zyxtai/subway-led-matrix/cadfiles/LEDmount1.stl

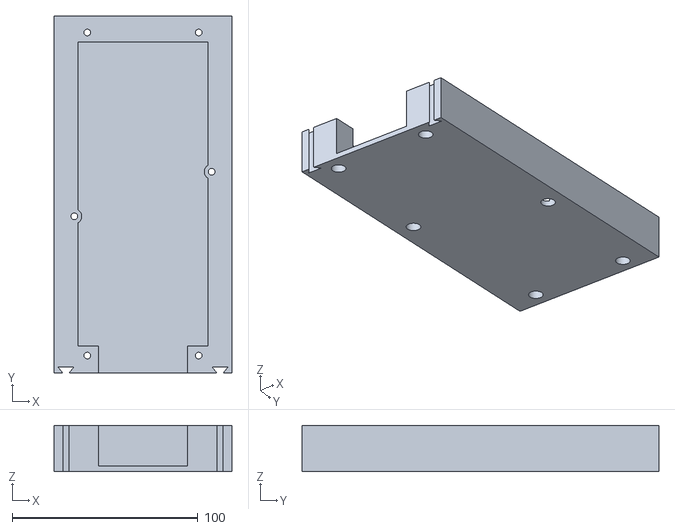
[picture p1: CAD file, 2026-10-25]
cadfiles/LEDmount1.stl
95.8 x 192.3 x 25.0
