zyxtai/subway-led-matrix/cadfiles/LEDmount2.stl

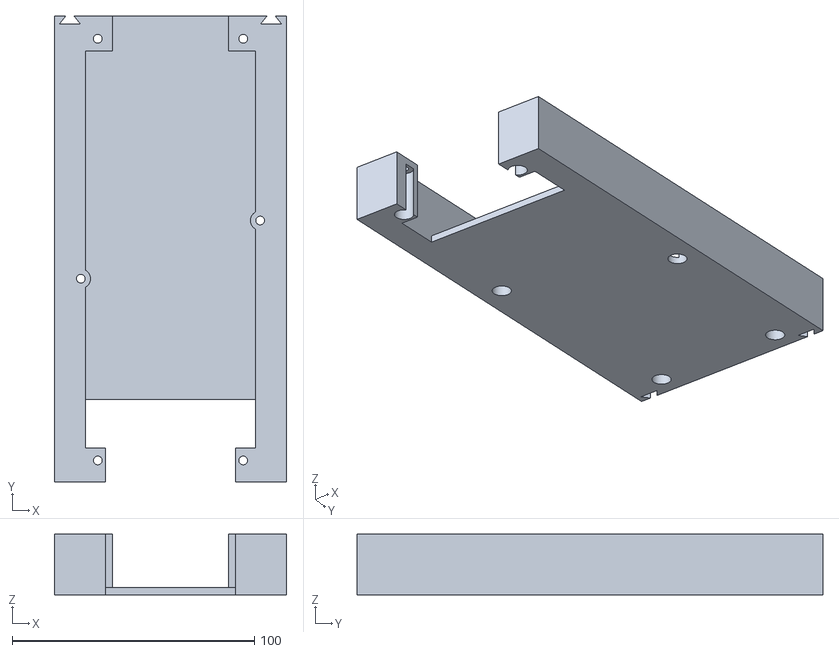
[picture p2: CAD file, 2026-10-25]
cadfiles/LEDmount2.stl
95.8 x 192.3 x 25.0
