zyxtai/subway-led-matrix/cadfiles/connectingpin1.stl

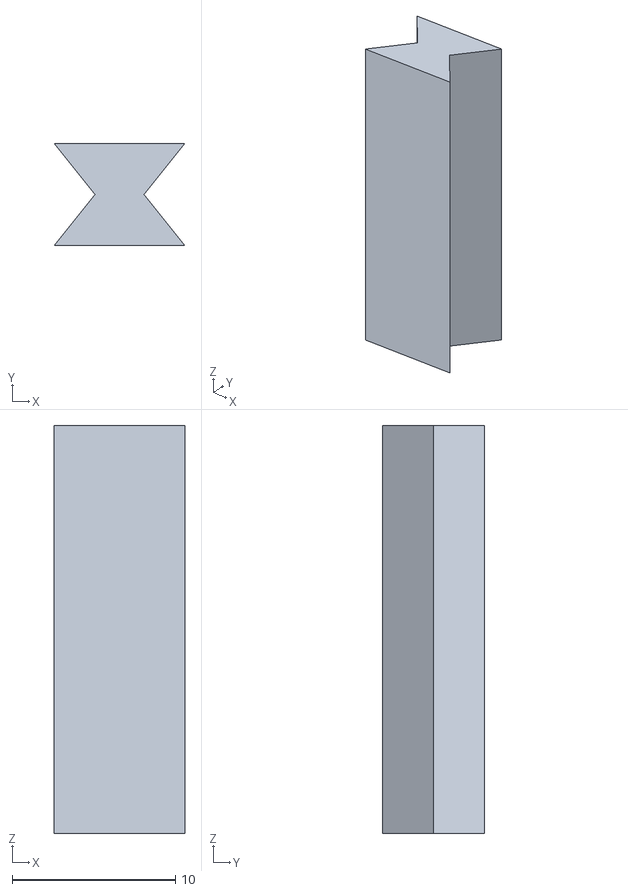
[picture p3: CAD file, 2026-10-25]
cadfiles/connectingpin1.stl
8.00 x 6.25 x 25.0
