zyxtai/subway-led-matrix/(list of files, cad)

Other CAD files:
cadfiles/connectingpin2.stl
