zyxtai/subway-led-matrix/(commit log)

2026-10-24 added wifi connection
    changed settings.toml in the CIRCUITPY disk
2026-10-25 cad files, subway code for E,F,R,M
    [LEDmount1.stl, LEDmount2.stl, connectingpin1.stl, connectingpin2.stl]
2026-10-31 newest (untested) fix for morning not waking up
    addition of nyan cat and also the board logs
    [arrival_ui.py, diagnostic_log.py, nyan_overlay.py, runtime_policy.py]
2026-10-31 feat: record startup progress and application failures
    [diagnostic_log.py, sign_app.py]
